mikhailvs/rc-car-kit/Gearbox3.FCStd

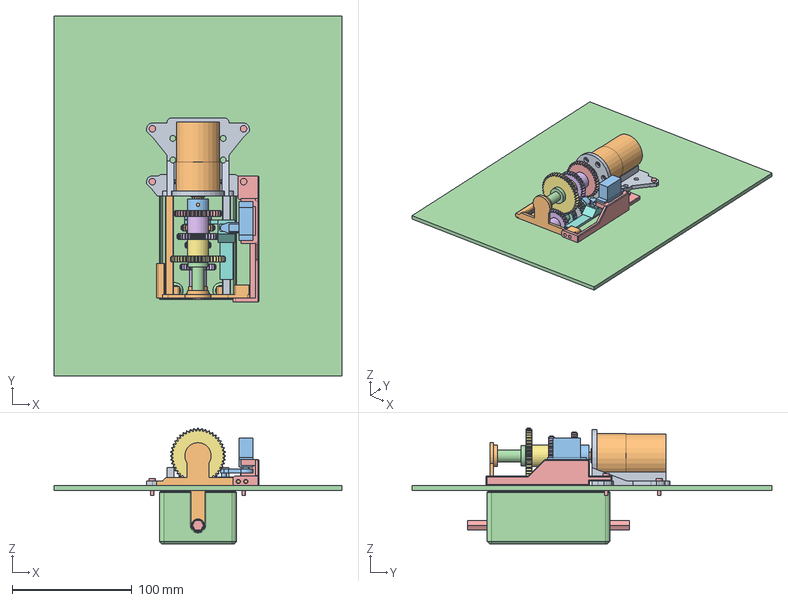
[picture p1: CAD file, 2026-11-14]
Gearbox3.FCStd
240.0 x 300.0 x 96.3 mm
Bracket
FrontPlate
MotorCarrier
MotorCap
MotorGear_B
MotorGear_A
MotorGear_C
SlideCarrier
SlideGear_A
SlideGear_B
SlideCap
Layshaft
ThroughShaft
T1
T2
ShiftFork
Rod_1
Rod_2
ServoArm
CasePan
ServoMount
Sleeve_1
Sleeve_2
Sleeve_3
Sleeve_4
Ref_Motor
Ref_Servo
Ref_Floor
Ref_Bolts
