mikhailvs/rc-car-kit/WheelMount2.FCStd

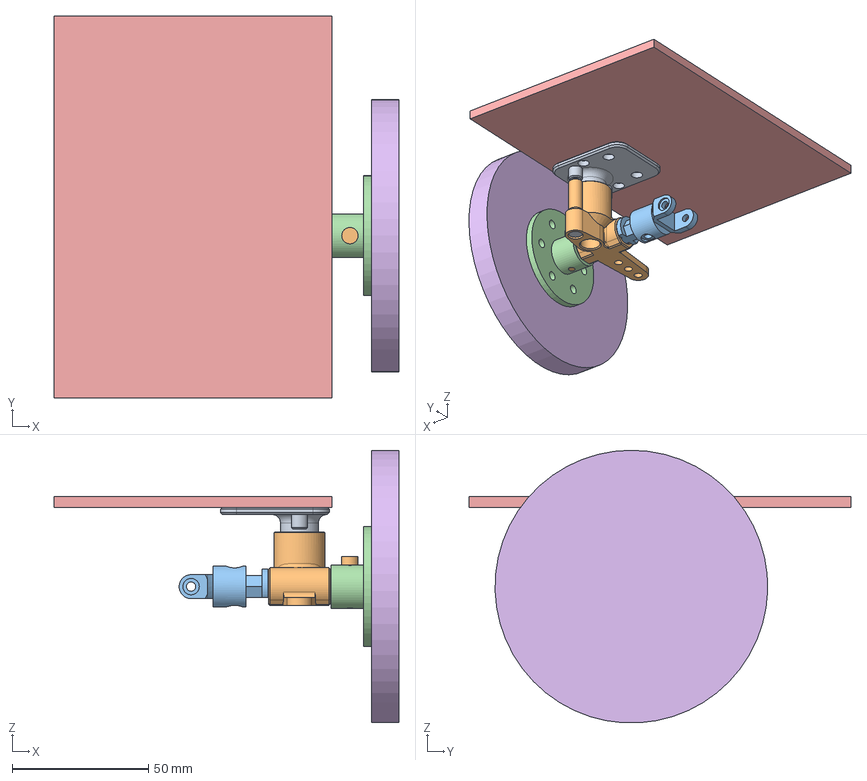
[picture p2: CAD file, 2026-11-13]
WheelMount2.FCStd
126.5 x 140.0 x 99.9 mm
Mount
Knuckle
Stub
WheelHub
Ref_Floor
Ref_Disc
Ref_KingpinBolt
Ref_Washer
Ref_LockBolt
Ref_HubScrew
Ref_JointYoke
