mikhailvs/rc-car-kit/Differential.FCStd

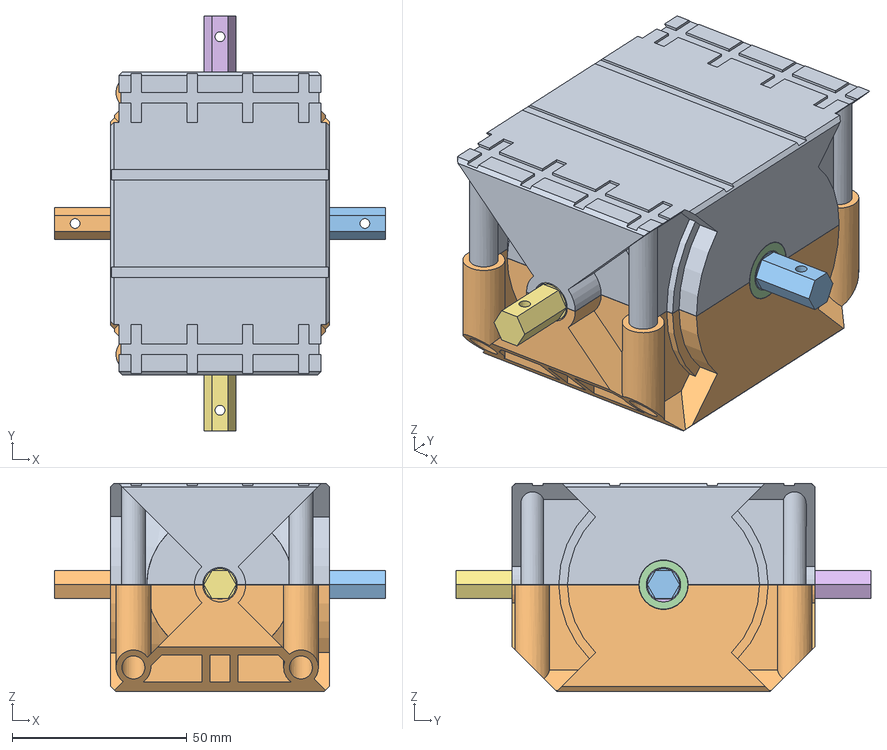
[picture p3: CAD file, 2026-11-13]
Differential.FCStd
94.8 x 118.8 x 59.6 mm
Carrier
Cap
Bushing_L
Bushing_R
SideGear_L
SideGear_R
SpiderGear_1
SpiderGear_2
SpiderPin
HalfShaft_L
HalfShaft_R
PinionA
PinionB
PinionShaftA
PinionShaftB
IdlerRing
CaseTop
CaseBottom
