mikhailvs/rc-car-kit/WheelMount.FCStd

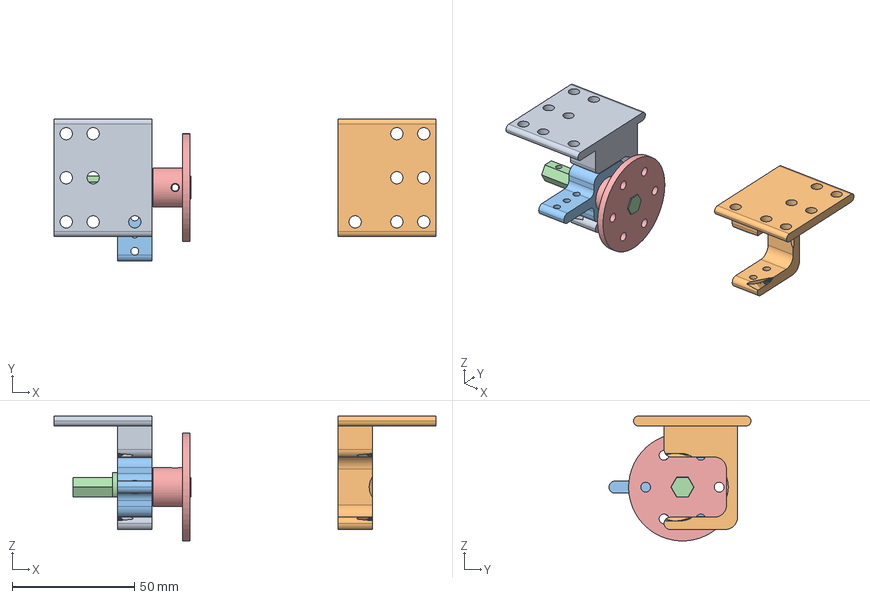
[picture p4: CAD file, 2026-11-13]
WheelMount.FCStd
156.0 x 58.0 x 51.0 mm
Mount_R
Mount_L
Knuckle
Stub
WheelHub
