mikhailvs/rc-car-kit/CvtModule.FCStd

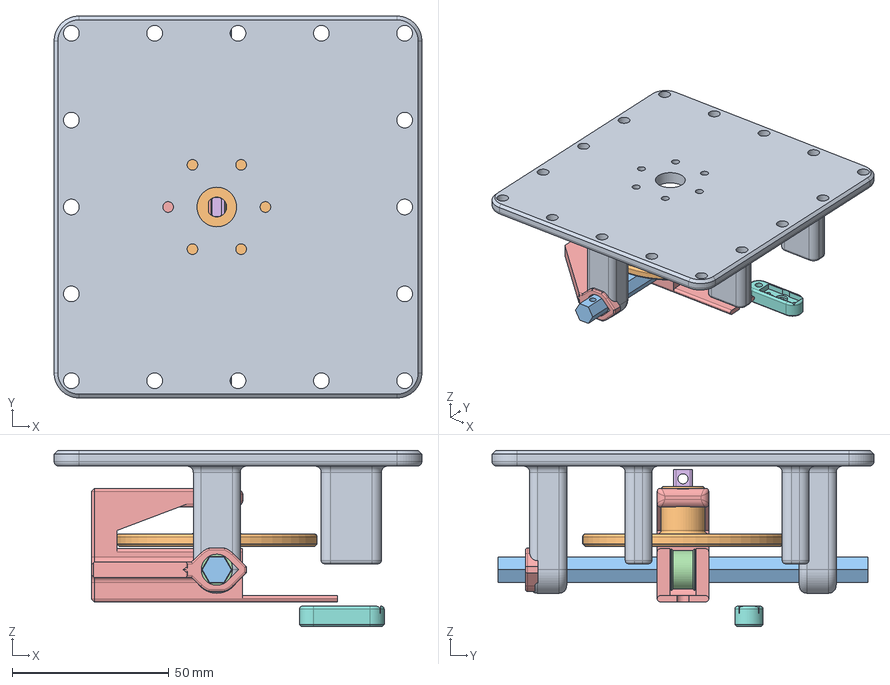
[picture p5: CAD file, 2026-11-13]
CvtModule.FCStd
117.2 x 121.7 x 56.1 mm
Lid
Disc
ThroughShaft
Wheel
Shuttle
RollerSlider
Roller
ServoArm
