mikhailvs/rc-car-kit/MotorModule.FCStd

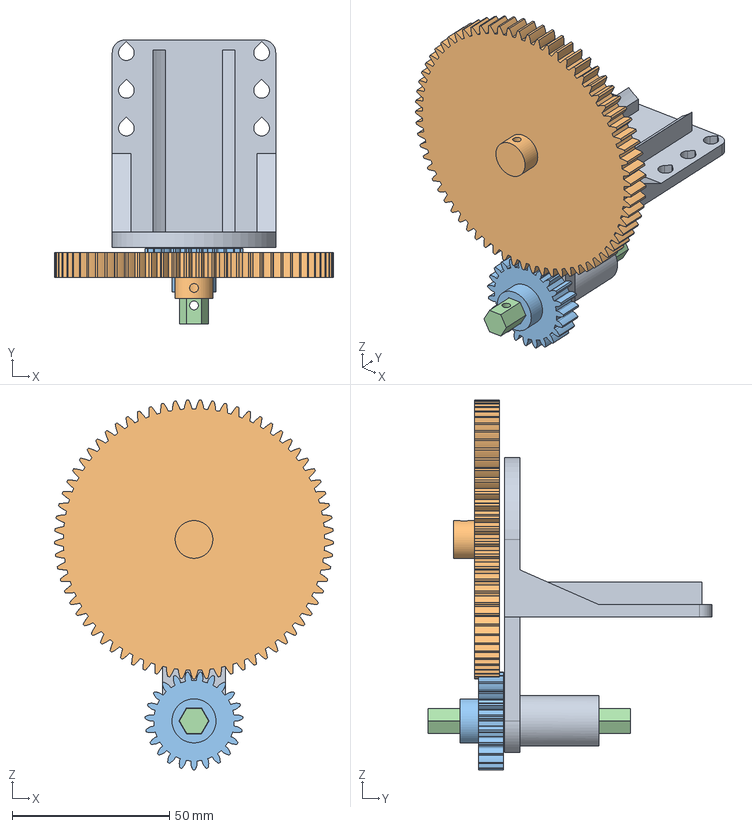
[picture p6: CAD file, 2026-11-13]
MotorModule.FCStd
88.7 x 90.3 x 117.7 mm
Bracket
MotorGear
ShaftGear
ThroughShaft
