mikhailvs/rc-car-kit/DriveShaft.FCStd

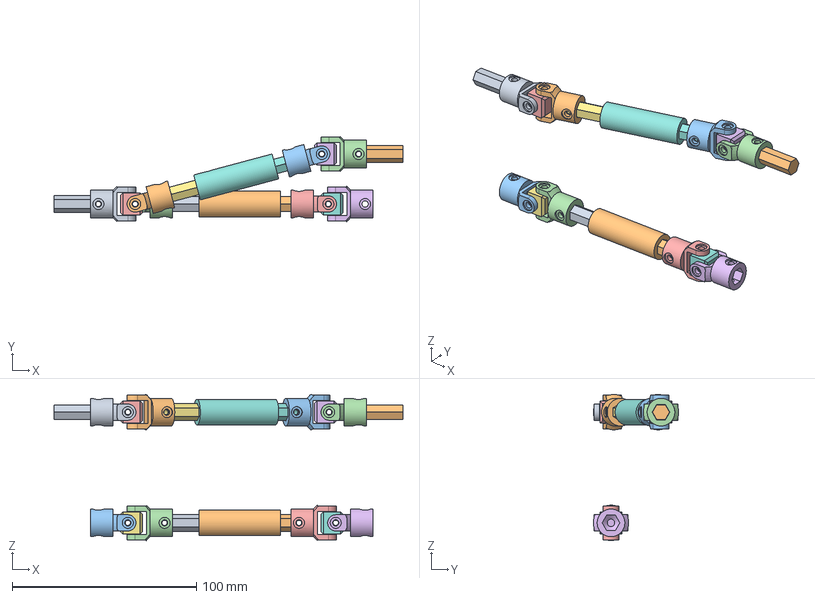
[picture p7: CAD file, 2026-11-13]
DriveShaft.FCStd
189.2 x 46.3 x 79.2 mm
Shown_JointYoke_1
Shown_JointYoke_2
Shown_JointYoke_3
Shown_JointYoke_4
Shown_JointCross_1
Shown_JointCross_2
Shown_SlideRod
Shown_SlideTube
DummyPort_1
DummyPort_2
JointYoke_1
JointYoke_2
JointYoke_3
JointYoke_4
JointCross_1
JointCross_2
SlideRod
SlideTube
