mikhailvs/rc-car-kit/(commit log)

2026-11-13 rc car kit: drivetrain module generators and models
    Claude-Session: https://claude.ai/code/session_019nNXSejCi7veYV5aWjsW3r
    [CvtModule.FCStd, Differential.FCStd, DriveShaft.FCStd, MotorModule.FCStd, WheelMount.FCStd]
2026-11-13 motor module: looser d bore flat, longer pad gussets
    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
    [MotorModule.FCStd]
2026-11-13 drive shaft: looser hinge clearances, shorter clamp screws
    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
    [DriveShaft.FCStd]
2026-11-13 cvt module: pinched disc, lego tire, mg995 shifter
    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
    [CvtModule.FCStd]
2026-11-13 cvt module: wider lug gaps, 3.2 arm pin hole, assembly notes
    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
    [CvtModule.FCStd]
2026-11-13 motor module: shaft bore 9.6 to 9.9 after tight test print
    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
    [MotorModule.FCStd]
2026-11-13 cvt module: restore slider to lid clearance limit to 0.4
    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
    [CvtModule.FCStd]
2026-11-13 wheel mount: knuckle axle bore 9.6 to 9.9 after tight test print
    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
    [WheelMount.FCStd]
2026-11-13 differential: enclosed clamshell axle module with balancing idler ring
    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
    [Differential.FCStd]
2026-11-13 differential: 0.3 mm running fits after tight test print, case and idler clearances, fit asserts
    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
    [Differential.FCStd]
2026-11-13 adding second wheel mount design on a single kingpin post
    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
    [WheelMount2.FCStd]
2026-11-13 wheel mount 2: one kingpin bolt from below replaces the side screws
    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
    [WheelMount2.FCStd]
2026-11-14 adding 3 speed gearbox module with bottom case and liner pockets
    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
    [Gearbox3.FCStd]
